agusff/Glov-Arm-Brazo-Robotico-controlado-por-Guante/Imagenes/PrototipoBrazo_1.jpeg

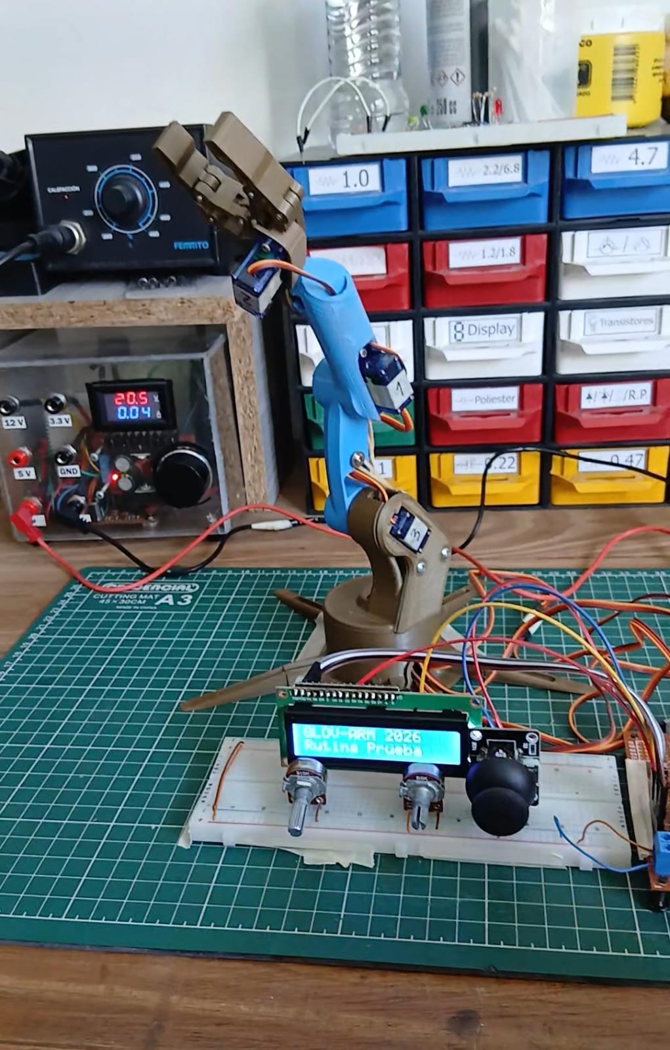
Imagenes/PrototipoBrazo_1.jpeg
