agusff/Glov-Arm-Brazo-Robotico-controlado-por-Guante/Firmware_BrazoRobot/Test_Brazo_Completo/Test_Brazo_Completo.ioc

Mcu.UserName=STM32F411CEUx
PA0-WKUP.Signal=S_TIM2_CH1_ETR
PA1.Signal=S_TIM2_CH2
PA10.Signal=USART1_RX
PA13.Signal=SYS_JTMS-SWDIO
PA14.Signal=SYS_JTCK-SWCLK
PA2.Signal=S_TIM2_CH3
PA3.Signal=S_TIM2_CH4
PA6.Signal=S_TIM3_CH1
PA9.Signal=USART1_TX
PB12.GPIO_Label=Pin_Btn
PB12.Signal=GPXTI12
PB6.Signal=I2C1_SCL
PB7.Signal=I2C1_SDA
