agusff/Glov-Arm-Brazo-Robotico-controlado-por-Guante/(commit log)

2026-09-13 Agregado de calculo de angulos en guante
2026-09-17 mejora manejo de sensores
2026-09-27 Reduccion de potencia de transmision ESP-NOW para mejorar vinculacion
2026-10-31 Update Hall sensor filtering method in README
    Replaced threshold comparator filtering with exponential moving average for Hall sensor readings.
