agusff/Glov-Arm-Brazo-Robotico-controlado-por-Guante/(notices)

Notices in the files:
Firmware_BrazoRobot/Test_Brazo_Completo/Core/Src/main.c:
Copyright (c) 2026 STMicroelectronics.
All rights reserved.
This software is licensed under terms that can be found in the LICENSE file
